withattribution/rose/fabrication/seeed fusion/Bom-template.csv

Part/Designator | Manufacture Part Number/Seeed SKU | Quantity
C1 | RHA0J471MCN1GS | 1
D1,D2 | CC0603KRX7R9BB102 | 2
