withattribution/rose/spice models/LT6240_positive_feedback.asc

B1: bv; V=(white(2e6*time)/10)
M1: nmos; BSB012NE2LX
M2: nmos; BSB012NE2LX
M3: nmos; BSB012NE2LX
M4: nmos; BSB012NE2LX
M5: pmos; FDS4465
M6: pmos; FDS4465
M9: nmos; BSB012NE2LX
M10: nmos; BSB012NE2LX
M11: pmos; FDS4465
M12: pmos; FDS4465
Q1: npn
Q2: npn
R1: res; 3.3k
R2: res; 10k
R3: res; 3.3k
R4: res; 10k
R5: res; 3.3k
R6: res; 10k
R7: res; 1K
R8: res; 1K
R9: res; 1K
R10: res; 1K
R11: res; 1K
U2: LTC6240
V1: voltage; PULSE(0 12 4m 10m 1m 5m 20m 3)
V3: voltage; PULSE(3.3 0 10m 0 0 10m)
V4: voltage; 3.3V
Named nets: 0, 12_REG_SIM, 3.3_REG, OP_OUT, NOISE, ENABLE_PULSE, DIGI_PIN, DIV, INPUT_TH, noise_sig, OP_INVERT, NAND_OUT, NOR_OUT, _OP_OUT, SHND
.tran 1u 80m
* .step param R LIST 53K 80K 100K
LT260 schmitt trigger design to mediate slow start up time of 12V 
switching regulator. Future design would invert the schmitt trigger 
and then feed that signal to a 2 channel NAND gate. The first channe 
will trigger when an associated digital signal is HIGH allowing the PWN 
circuit to be enabled.
To enable the LED dimming circuit the inverted schmitt trigger output 
would pass through the inverter then into the NAND gate, an 
associated digital pin will enable a high output which will pass through 
yet another inverter to activate the dimming circuit.
REV A designs shipped with a flaw that can be fixed by switching to a 
2 channel NOR gate. This design requires that the digital pin is LOW to 
activate both PWM and LED dimming circuits.
