withattribution/rose/spice models/LED_dimming.asc

M1: nmos; BSB012NE2LX
M2: nmos; BSB012NE2LX
R1: res; 6.81K
R2: res; 3.32K
R3: res; 3.3k
R4: res; 10k
R5: res; 3.3k
R6: res; 10k
R7: res; 3.3k
R8: res; 1K
U1: LT1783
U3: LT1783
V1: voltage; 3.3V
V2: voltage; 12V
V3: voltage; PULSE(0 3.3 0 1u 1u .5m 1m)
V4: voltage; PULSE(0 12 4m 10m 1m 5m 20m 3)
V5: voltage; PULSE(0 3.3 10m 0 0 10m 10 3)
Named nets: 3.3_REG, 0, 12_REG, ESP_PWM, DIM_PWM, REF, OP_OUT, ENABLE_PULSE, DIGI_PIN, DIV, INPUT_TH, IN
.tran 1u 80m
* .step param R LIST 53K 80K 100K
LT1783 0-3.3V PWM to 0-10V PWM for LED dimming
