withattribution/rose/spice models/Piezo_driver.asc

C1: cap; 1p; mfg="   ---" pn="   ---" type="   ---"
C3: cap; 56p; mfg="   ---" pn="   ---" type="   ---"
C4: cap; 1µ
C5: cap; .47µ
L2: ind; 47µ; Ipk=1.8 Rser=135m Rpar=32.406K Cpar=0 mfg="Bourns, Inc." pn="SRR1240-470M"
R5: res; 105K
R6: res; 10K
R8: res; 9.09K
R9: res; 10K
R10: res; 100K
R11: res; 453K
R12: res; 16.5K
U2: ICM7555
U3: LT3469
V1: voltage; 3.3V
V2: voltage; 12V
Named nets: 0, V12, V33, rc, PWM_OUT, driver_out, VCC_LT
.tran 1m 4m startup
.include ./icm7555.sub
100kHz pulse driving LT3469 piezo driver
