withattribution/rose/spice models/RC_7555.asc

C1: cap; 100p; mfg="   ---" pn="   ---" type="   ---"
C2: cap; 10n; mfg="   ---" pn="   ---" type="   ---"
R1: res; 100K
R2: res; 30K
U1: ICM7555
V1: voltage; 12V
V2: voltage; 3.3V
Named nets: 0, V12, V33, PWM_OUT, rc
.tran 1m 4m startup
.include ./icm7555.sub
