withattribution/rose/spice models/Solar_MPPT.asc

C3: cap; 10µ
C4: cap; 1µ
C5: cap; 10µ
C6: cap; 47µ
C7: cap; 47µ
D1: schottky; MBRS340
D5: zener; EDZV16B
D6: diode; 1N4148
L2: ind; 10µH; Rpar=10K
M1: pmos; FDS4685
R2: res; 221K
R3: res; 30K
R4: res; 330K
R5: res; 100K
R6: res; 9.09K
R7: res; 50k
R8: res; 10K
R9: res; .05
U1: LT3652
V2: voltage; 28
Named nets: 0, IN, V_BATT, REG_27
.tran 3m startup
14V to 32V MPPT
R1 = ((R2*Vin)/Vout) - R2
418K @ 14V
1MEG @32V
Basic MPPT model with similar components
(mostly for sizing inductor)
