withattribution/rose/hardware/rose.brd

## EAGLE design hardware/rose.brd (2016-06-25)

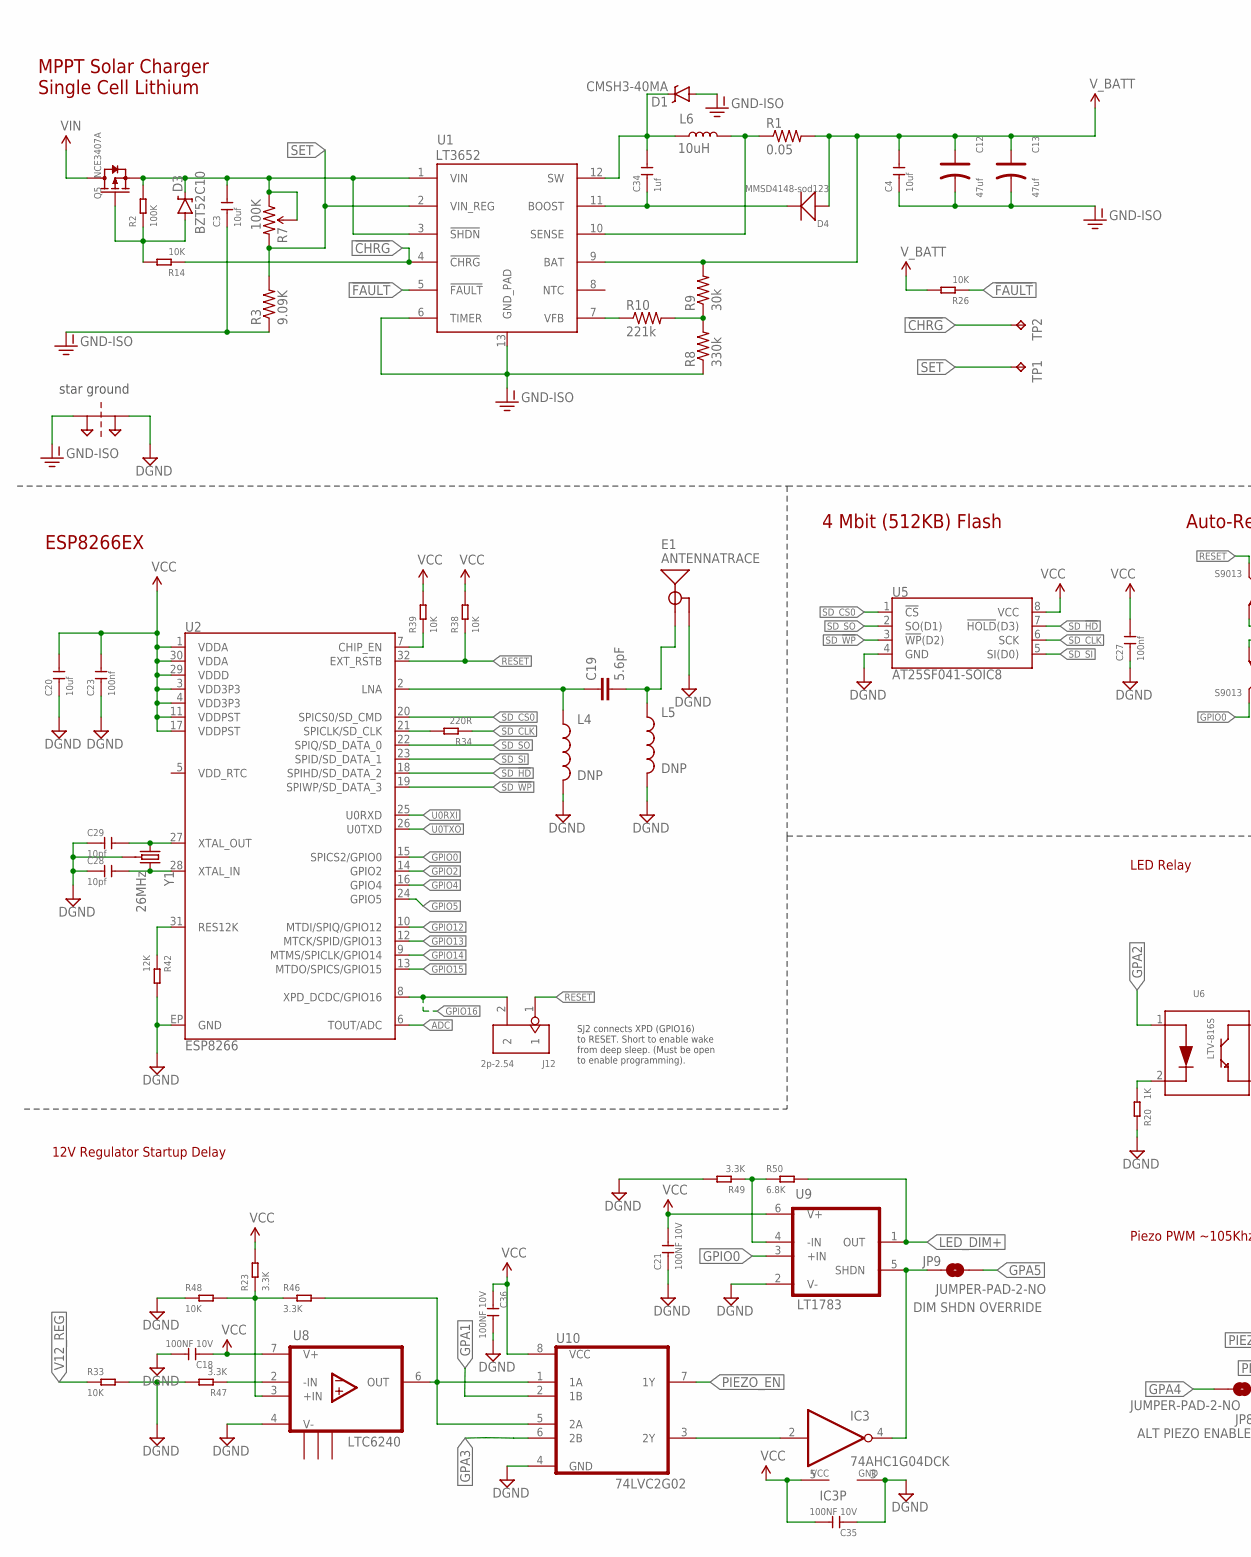
[picture p1: schematic rose.sch, sheet 1, part in row 1, column 1]

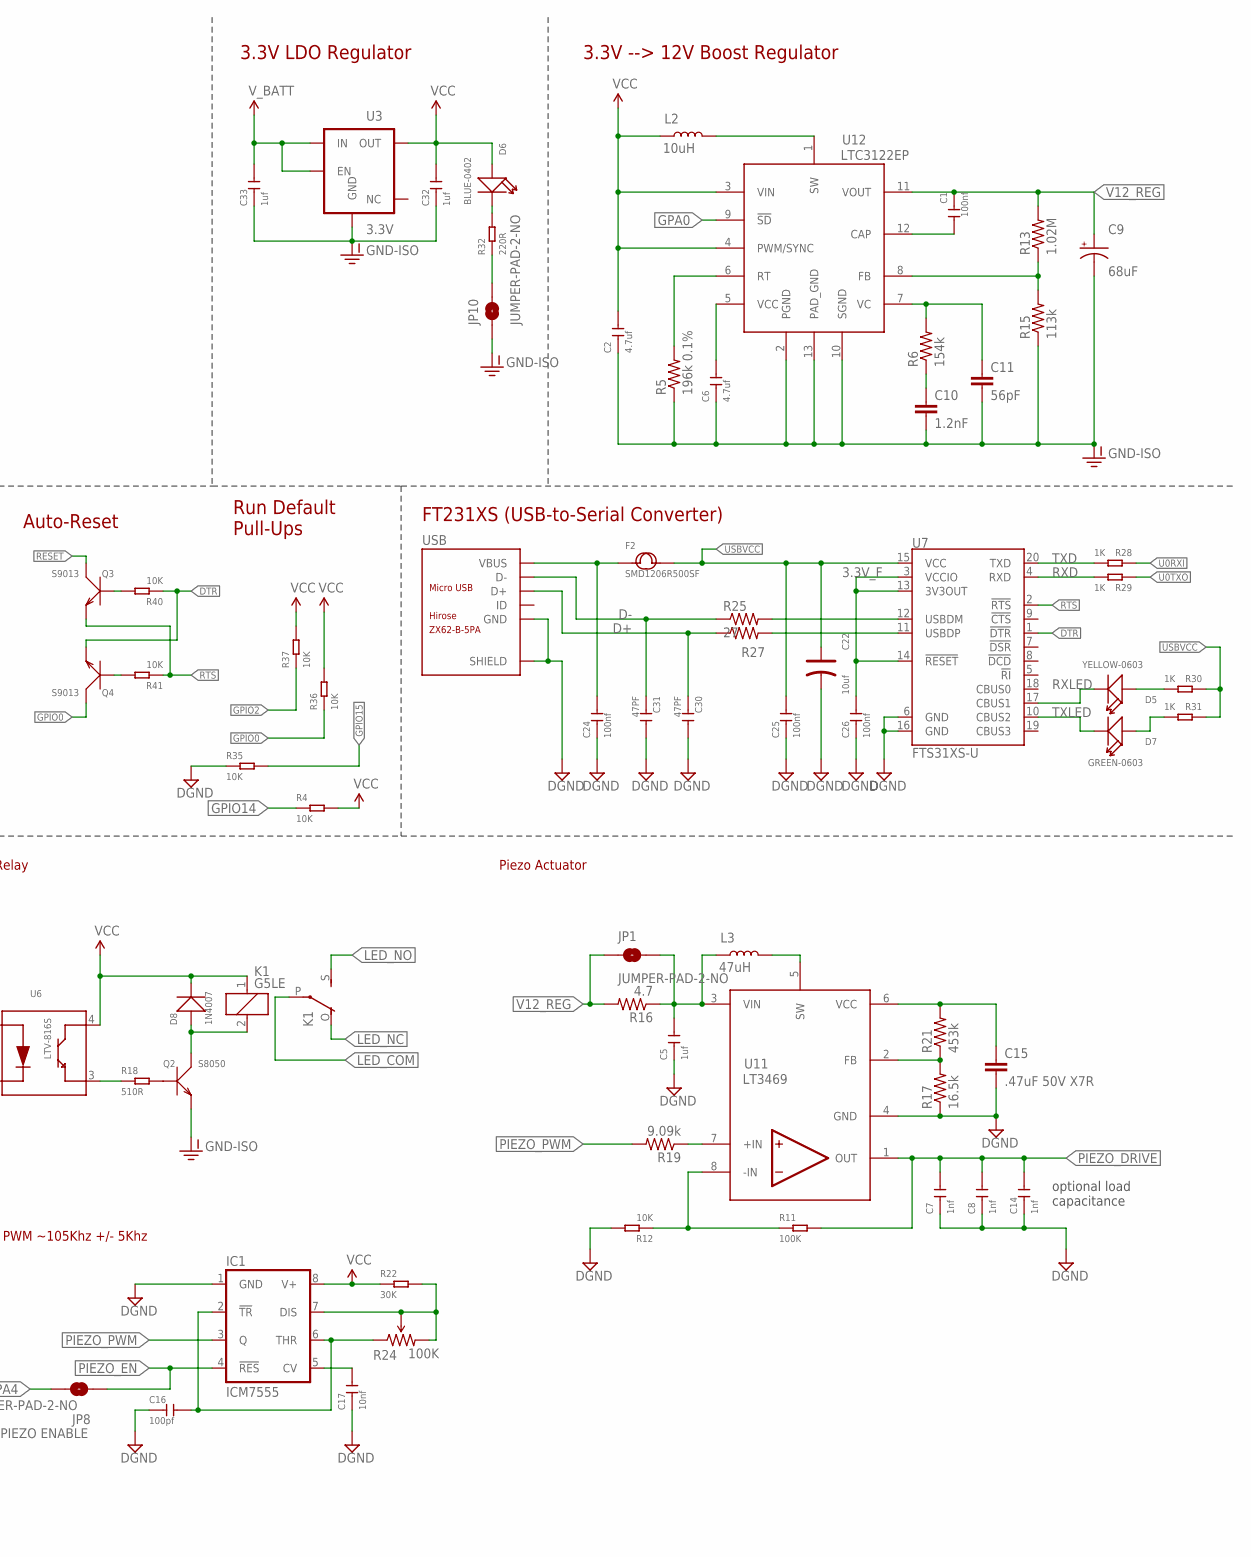
[picture p2: schematic rose.sch, sheet 1, part in row 1, column 2]

Parts:
C1, C23, C24, C25, C26, C27: 100nf; C0402
C2, C6: 4.7uf; C0603
C3, C4: 10uf; C0805
C5, C32, C33, C34: 1uf; C0603
C7, C8, C14: 1nf; C0402
C9: 68uF; EIA6032
C10: 1.2nF; 0603-CAP
C11: 56pF; 0603-CAP
C12, C13: 47uf; AVX-C
C15: .47uF 50V X7R; 0603-CAP
C16: 100pf; C0603
C17: 10nf; C0402
C18, C21, C35, C36: 100NF 10V; C0402
C19: 5.6pF; 0603-CAP
C20: 10uf; C0402
C22: 10uf; AVX-A
C28, C29: 10pf; C0402
C30, C31: 47PF; C0402
D1: CMSH3-40MA; SMA-DIODE
D3: BZT52C10; SOD-123
D4: MMSD4148-sod123; SOD-123
D5: YELLOW-0603; LED-0603
D6: BLUE-0402; LED-0402
D7: GREEN-0603; LED-0603
D8: 1N4007; DO-214AC
E1: ANTENNATRACE; TRACE_ANTENNA_2.4GHZ_25.7MM
F2: SMD1206R500SF; F1206
IC1: ICM7555; SO08
IC3: 74AHC1G04DCK; SC70-5
J12: 2p-2.54; H2-2.54
JP1, JP8, JP9, JP10: JUMPER-PAD-2-NO; PAD-JUMPER-2-NO_NO_SILK
K1: G5LE
L2, L6: 10uH; SRR1240
L3: 47uH; SRR1240
L4, L5: DNP; 0603
PT1: 2PT_GND_TIE
Q2: S8050; SOT-23
Q3, Q4: S9013; SOT-23
Q5: NCE3407A; SOT-23
R1: 0.05; 1206
R2, R11: 100K; R0603
R3: 9.09K; 0603-RES
R4, R12, R14, R26, R33, R35, R36, R37, R38, R39, R40, R41, R48: 10K; R0603
R5: 196k 0.1%; 0603-RES
R6: 154k; 0603-RES
R7, R24: 100K; ST4ETA
R8: 330k; 0603-RES
R9: 30k; 0603-RES
R10: 221k; 0603-RES
R13: 1.02M; 0603-RES
R15: 113k; 0603-RES
R16: 4.7; 0603-RES
R17: 16.5k; 0603-RES
R18: 510R; R0603
R19: 9.09k; 0603-RES
R20, R28, R29, R30, R31: 1K; R0603
R21: 453k; 0603-RES
R22: 30K; R0603
R23, R46, R47, R49: 3.3K; R0603
R25, R27: 27; 0603-RES
R32, R34: 220R; R0603
R42: 12K; R0603
R50: 6.8K; R0603
TP1, TP2: TPTP10SQ; TP10SQ
U1: LT3652; MSOP-12_GND
U2: ESP8266; QFN32
U3: 3.3V; SOT23-5
U5: AT25SF041-SOIC8; SO08
U6: LTV-816S; SMD4-2.54-4.6X6.5MM
U7: FTS31XS-U; SSOP20_L
U8: LTC6240; SOIC-8
U9: LT1783; TSOT-23-6
U10: 74LVC2G02; TSSOP-8
U11: LT3469; TSOT-23-8
U12: LTC3122EP; 12MSOP
USB: ZX62-B-5PA; MICRO-USB5+6P-SMD-0.65-AB
Y1: 26MHz; CRYSTAL-SMD-3.2X2.5

Connections:
3.3V_F: C26.2, U7.3 (VCCIO), U7.13 (3V3OUT), U7.14 (!RESET)
!CHRG: R14.1, TP2.TP, U1.4 (!CHRG)
!FAULT: R26.1, U1.5 (!FAULT)
ADC: U2.6 (TOUT/ADC); also elsewhere on the board
BOOST: C34.1, D4.-, U1.11 (BOOST)
CHIP_EN: R39.1, U2.7 (CHIP_EN)
D+: C30.1, R27.1, USB.3 (D+)
D-: C31.1, R25.1, USB.2 (D-)
DGND: C5.1, C7.1, C8.1, C14.1, C15.2, C16.1, C17.1, C18.2, C20.1, C21.1, C22.-, C23.1, C24.1, C25.1, C26.1, C27.1, C28.1, C29.1, C30.2, C31.2, C35.1, C36.2, E1.GND, E1.GND2 (GND), IC1.1 (GND), IC3.3 (GND), L4.2, L5.2, PT1.P$2, R12.2, R17.1, R20.2, R33.2, R35.1, R42.2, R47.2, R48.1, R49.2, U2.EP (GND), U5.4 (GND), U7.6 (GND), U7.16 (GND), U8.4 (V-), U9.2 (V-), U10.4 (GND), U11.4 (GND), USB.5 (GND), USB.P1 (SHIELD), USB.P2 (SHIELD), USB.P3 (SHIELD), USB.P4 (SHIELD), USB.P5 (SHIELD), USB.P6 (SHIELD), Y1.2 (GND), Y1.4 (GND); also elsewhere on the board
DTR: Q4.2 (E), R40.1, U7.1 (!DTR)
FB: R8.2, R9.1, R10.2
GND-ISO: C2.1, C3.1, C4.1, C6.1, C9.P$2 (-), C10.2, C11.2, C12.-, C13.-, C32.1, C33.1, D1.A, JP10.1, PT1.P$1, Q2.2 (E), R3.1, R5.1, R8.1, R15.1, U1.6 (TIMER), U1.13 (GND_PAD), U3.2 (GND), U12.2 (PGND), U12.10 (SGND), U12.13 (PAD_GND); also elsewhere on the board
GPA0: U12.9 (!SD); also elsewhere on the board
GPA1: U10.2 (1B); also elsewhere on the board
GPA2: U6.1 (ANODE); also elsewhere on the board
GPA3: U10.6 (2B); also elsewhere on the board
GPA4: JP8.1; also elsewhere on the board
GPA5: JP9.1; also elsewhere on the board
GPIO0: Q4.3 (C), R36.1, U2.15 (SPICS2/GPIO0), U9.3 (+IN)
GPIO2: R37.1, U2.14 (GPIO2); also elsewhere on the board
GPIO4: U2.16 (GPIO4); also elsewhere on the board
GPIO5: U2.24 (GPIO5); also elsewhere on the board
GPIO12: U2.10 (MTDI/SPIQ/GPIO12); also elsewhere on the board
GPIO13: U2.12 (MTCK/SPID/GPIO13); also elsewhere on the board
GPIO14: R4.1, U2.9 (MTMS/SPICLK/GPIO14); also elsewhere on the board
GPIO15: R35.2, U2.13 (MTDO/SPICS/GPIO15); also elsewhere on the board
GPIO16: J12.2, U2.8 (XPD_DCDC/GPIO16)
LED_COM: K1.P; also elsewhere on the board
LED_DIM+: R50.2, U9.1 (OUT); also elsewhere on the board
LED_NC: K1.O; also elsewhere on the board
LED_NO: K1.S; also elsewhere on the board
LNA: C19.1, L4.1, U2.2 (LNA)
LNA2: C19.2, E1.ANT (SIGNAL), L5.1
unnamed: R42.1, U2.31 (RES12K)
unnamed: C3.2, D3.C, Q5.2 (S), R2.2, R7.P$1 (CCW), R7.P$2 (WIPER), U1.1 (VIN), U1.3 (!SHDN)
unnamed: R10.1, U1.7 (VFB)
unnamed: R20.1, U6.2 (CATHODE)
unnamed: D3.A, Q5.1 (G), R2.1, R14.2
unnamed: IC1.7 (DIS), R22.2, R24.P$2 (WIPER), R24.P$3 (CW)
unnamed: C28.2, U2.28 (XTAL_IN), Y1.3 (2)
unnamed: D8.1 (+), K1.2, Q2.3 (C)
unnamed: C16.2, IC1.2 (!TR), IC1.6 (THR), R24.P$1 (CCW)
unnamed: R18.1, U6.3 (EMITER)
unnamed: C17.2, IC1.5 (CV)
unnamed: Q2.1 (B), R18.2
unnamed: C29.2, U2.27 (XTAL_OUT), Y1.1
unnamed: L2.P$2 (2), U12.1 (SW)
unnamed: R5.2, U12.6 (RT)
unnamed: C6.2, U12.5 (VCC)
unnamed: R46.2, U8.6 (OUT), U10.1 (1A), U10.5 (2A)
unnamed: C1.2, U12.12 (CAP)
unnamed: C11.1, R6.2, U12.7 (VC)
unnamed: R13.1, R15.2, U12.8 (FB)
unnamed: C10.1, R6.1
unnamed: L3.P$2 (2), U11.5 (SW)
unnamed: C5.2, JP1.2, L3.P$1 (1), R16.1, U11.3 (VIN)
unnamed: R11.1, R12.1, U11.8 (-IN)
unnamed: R19.1, U11.7 (+IN)
unnamed: C15.1, R21.2, U11.6 (VCC)
unnamed: R17.2, R21.1, U11.2 (FB)
unnamed: D7.+, R31.1
unnamed: D5.+, R30.1
unnamed: R25.2, U7.12 (USBDM)
unnamed: R27.2, U7.11 (USBDP)
unnamed: D6.-, R32.2
unnamed: JP10.2, R32.1
unnamed: Q3.1 (B), R40.2
unnamed: Q4.1 (B), R41.2
unnamed: R23.1, R46.1, R48.2, U8.3 (+IN)
unnamed: R47.1, U8.2 (-IN)
unnamed: R49.1, R50.1, U9.4 (-IN)
unnamed: IC3.2 (I), U10.3 (2Y)
unnamed: IC3.4 (O), JP9.2, U9.5 (SHDN)
PIEZO_DRIVE: C7.2, C8.2, C14.2, R11.2, U11.1 (OUT); also elsewhere on the board
PIEZO_EN: IC1.4 (!RES), JP8.2, U10.7 (1Y)
PIEZO_PWM: IC1.3 (Q), R19.2
RESET: J12.1, Q3.3 (C), R38.1, U2.32 (EXT_RSTB)
RTS: Q3.2 (E), R41.1, U7.2 (!RTS)
RXD: R29.1, U7.4 (RXD)
RXLED: D5.-, U7.17 (CBUS1)
SD_!HD!: U2.18 (SPIHD/SD_DATA_2), U5.7 (!HOLD!(D3))
SD_!WP!: U2.19 (SPIWP/SD_DATA_3), U5.3 (!WP!(D2))
SD_CLK: R34.1, U5.6 (SCK)
SD_CLK0: R34.2, U2.21 (SPICLK/SD_CLK)
SD_CS0: U2.20 (SPICS0/SD_CMD), U5.1 (!CS!)
SD_SI: U2.23 (SPID/SD_DATA_1), U5.5 (SI(D0))
SD_SO: U2.22 (SPIQ/SD_DATA_0), U5.2 (SO(D1))
SENSE: L6.P$2 (2), R1.1, U1.10 (SENSE)
SET: R3.2, R7.P$3 (CW), TP1.TP, U1.2 (VIN_REG)
SW: C34.2, D1.C, L6.P$1 (1), U1.12 (SW)
TXD: R28.1, U7.20 (TXD)
TXLED: D7.-, U7.10 (CBUS2)
U0RXI: R28.2, U2.25 (U0RXD); also elsewhere on the board
U0TXO: R29.2, U2.26 (U0TXD); also elsewhere on the board
USBVCC: C22.+, C25.2, F2.2, R30.2, R31.2, U7.15 (VCC)
V12_REG: C1.1, C9.P$1 (+), JP1.1, R13.2, R16.2, R33.1, U12.11 (VOUT); also elsewhere on the board
VBUS: C24.2, F2.1, USB.1 (VBUS)
VCC: C2.2, C18.1, C20.2, C21.2, C23.2, C27.2, C32.2, C35.2, C36.1, D6.+, D8.2 (-), IC1.8 (V+), IC3.5 (VCC), K1.1, L2.P$1 (1), R4.2, R22.1, R23.2, R36.2, R37.2, R38.2, R39.2, U2.1 (VDDA), U2.3 (VDD3P3), U2.4 (VDD3P3), U2.11 (VDDPST), U2.17 (VDDPST), U2.29 (VDDD), U2.30 (VDDA), U3.5 (OUT), U5.8 (VCC), U6.4 (COLLECTOR), U8.7 (V+), U9.6 (V+), U10.8 (VCC), U12.3 (VIN), U12.4 (PWM/SYNC); also elsewhere on the board
VIN: Q5.3 (D); also elsewhere on the board
V_BATT: C4.2, C12.+, C13.+, C33.2, D4.+, R1.2, R9.2, R26.2, U1.9 (BAT), U3.1 (IN), U3.3 (EN); also elsewhere on the board

Notes on the sheet:
optional load capacitance
FT231XS (USB-to-Serial Converter)
Auto-Reset
Run Default Pull-Ups
SJ2 connects XPD (GPIO16) to RESET. Short to enable wake from deep sleep. (Must be open to enable programming).
MPPT Solar Charger Single Cell Lithium
3.3V LDO Regulator
3.3V --> 12V Boost Regulator
ESP8266EX
4 Mbit (512KB) Flash
Piezo PWM ~105Khz +/- 5Khz
LED Relay
12V Regulator Startup Delay
Piezo Actuator
star ground
DIM SHDN OVERRIDE
ALT PIEZO ENABLE

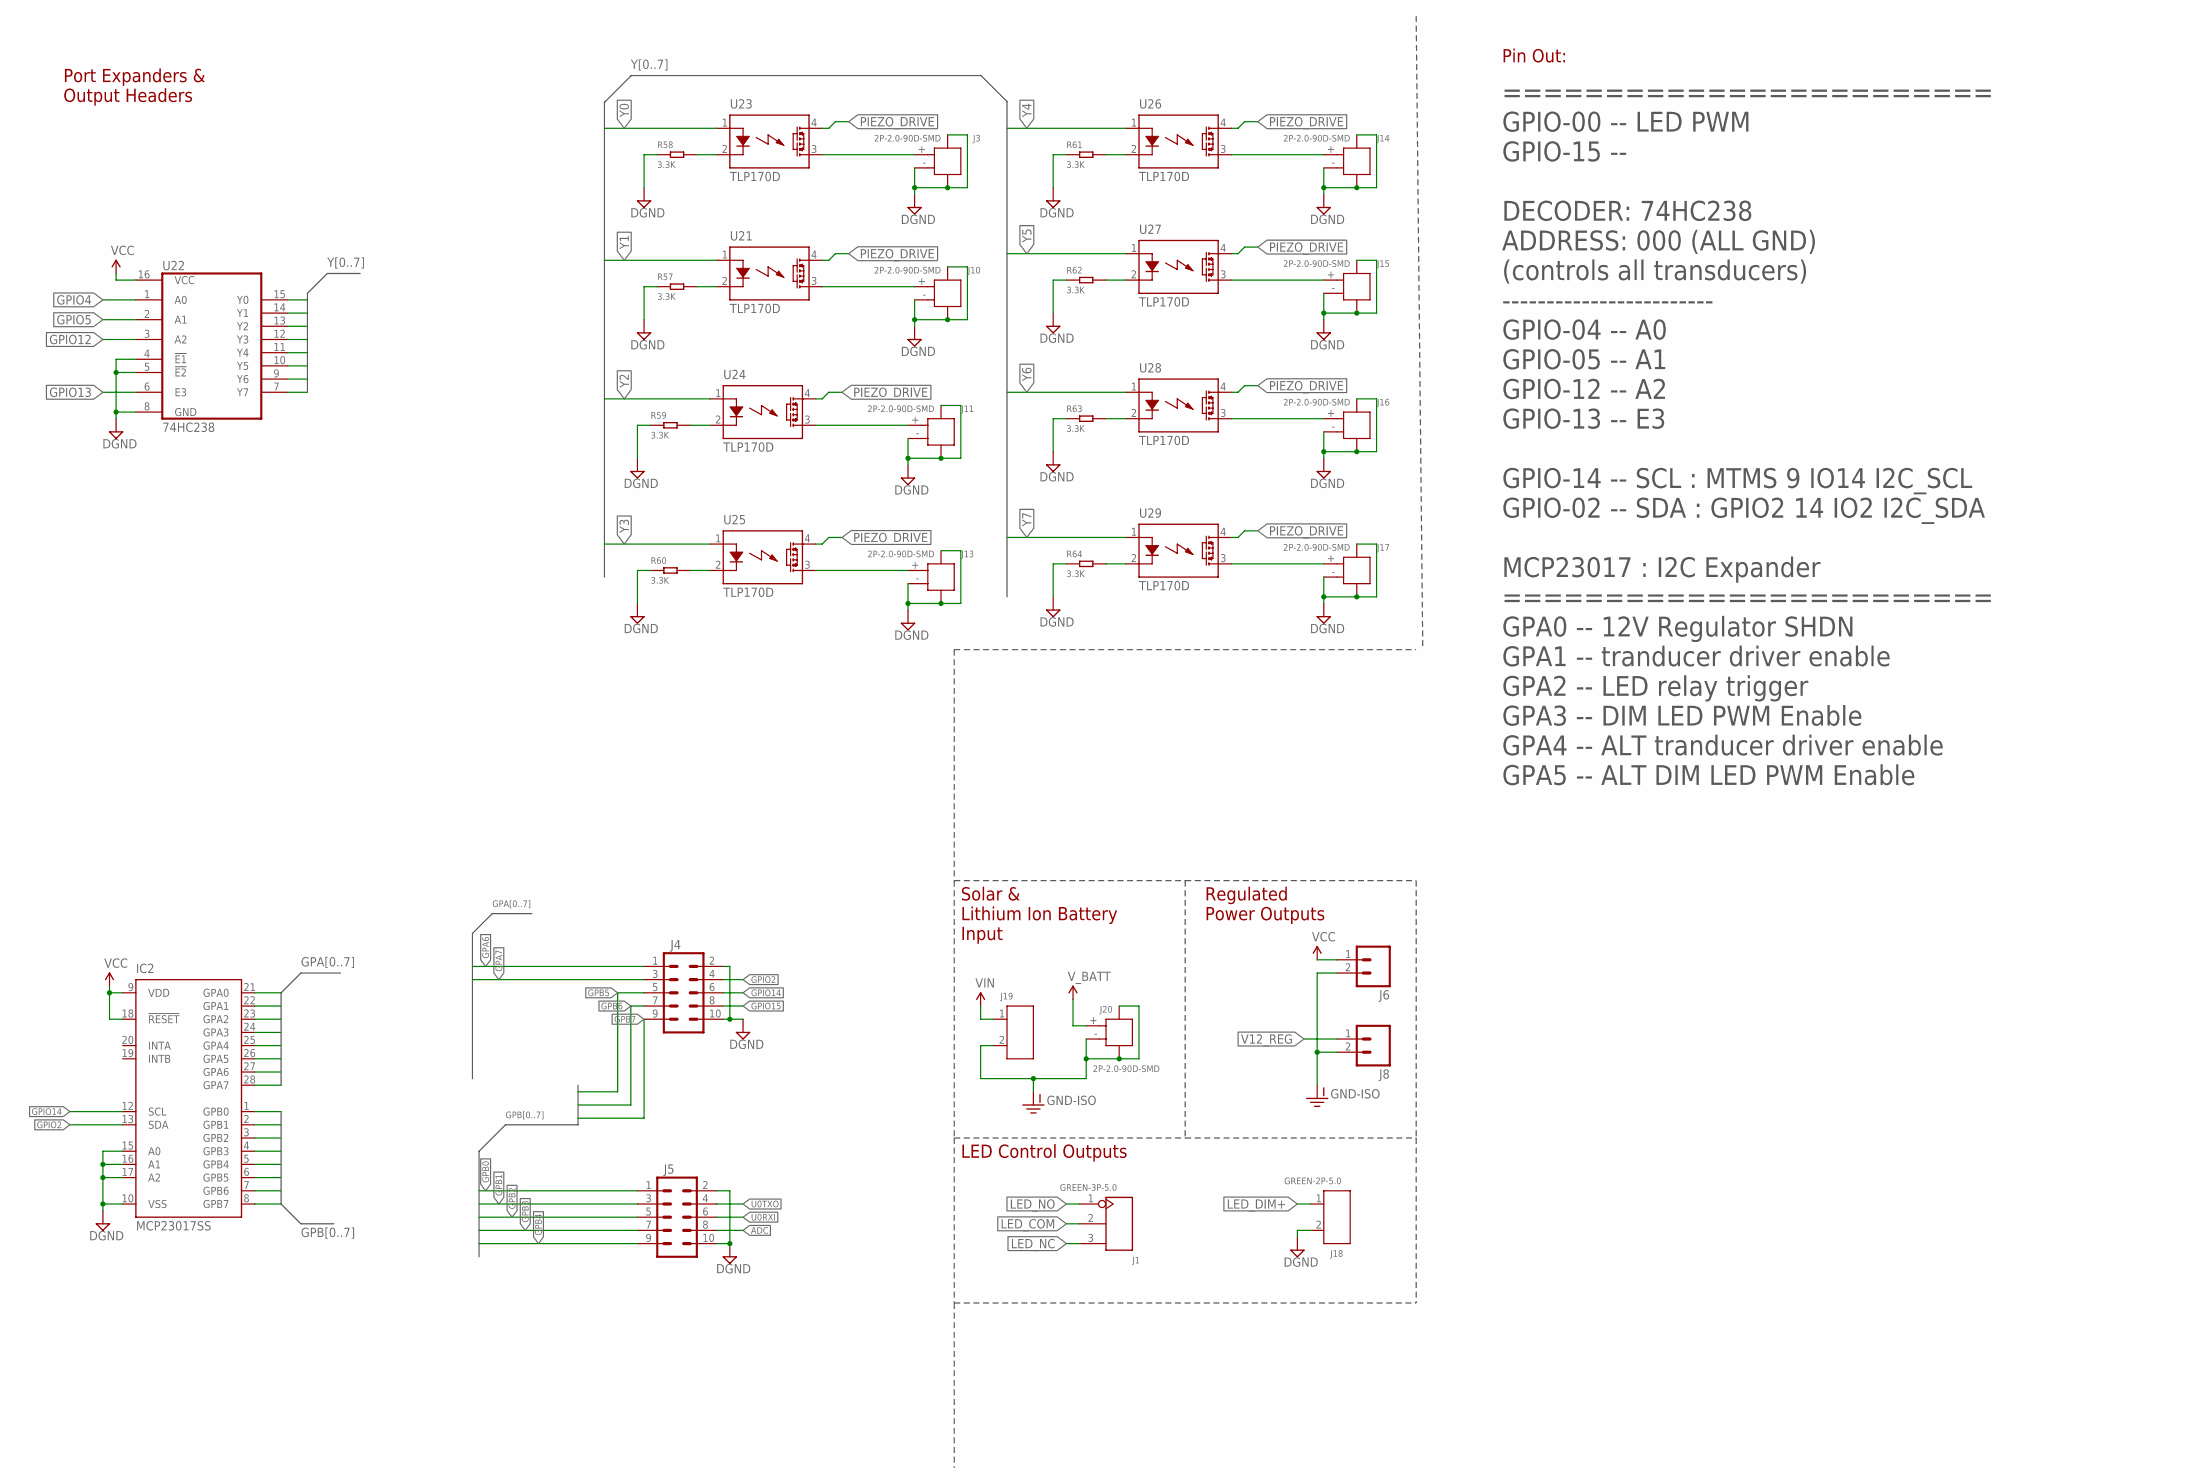
[picture p3: schematic rose.sch, sheet 2]

Parts:
IC2: MCP23017SS; SSOP28
J1: GREEN-3P-5.0; H3-5.0-15.5X8.0MM
J3, J10, J11, J13, J14, J15, J16, J17, J20: 2P-2.0-90D-SMD; HW2-SMD-2.0-90D
J4, J5: M05X2NO_SILK; 2X5_NOSILK
J6, J8: M02PTH; 1X02
J18, J19: GREEN-2P-5.0; H2-5.0-10.5X8.0MM
R57, R58, R59, R60, R61, R62, R63, R64: 3.3K; R0603
U21, U23, U24, U25, U26, U27, U28, U29: TLP170D; 4-SOP
U22: 74HC238; TSSOP-16

Connections:
ADC: J5.8; also elsewhere on the board
DGND: IC2.10 (VSS), IC2.15 (A0), IC2.16 (A1), IC2.17 (A2), J3.3, J3.4, J3.- (2), J4.2, J4.10, J5.2, J5.10, J10.3, J10.4, J10.- (2), J11.3, J11.4, J11.- (2), J13.3, J13.4, J13.- (2), J14.3, J14.4, J14.- (2), J15.3, J15.4, J15.- (2), J16.3, J16.4, J16.- (2), J17.3, J17.4, J17.- (2), J18.2, R57.1, R58.1, R59.1, R60.1, R61.1, R62.1, R63.1, R64.1, U22.4 (!E1), U22.5 (!E2), U22.8 (GND); also elsewhere on the board
GND-ISO: J6.2, J8.2, J19.2, J20.3, J20.4, J20.- (2); also elsewhere on the board
GPA0: IC2.21 (GPA0); also elsewhere on the board
GPA1: IC2.22 (GPA1); also elsewhere on the board
GPA2: IC2.23 (GPA2); also elsewhere on the board
GPA3: IC2.24 (GPA3); also elsewhere on the board
GPA4: IC2.25 (GPA4); also elsewhere on the board
GPA5: IC2.26 (GPA5); also elsewhere on the board
GPA6: IC2.27 (GPA6), J4.1
GPA7: IC2.28 (GPA7), J4.3
GPB0: IC2.1 (GPB0), J5.1
GPB1: IC2.2 (GPB1), J5.3
GPB2: IC2.3 (GPB2), J5.5
GPB3: IC2.4 (GPB3), J5.7
GPB4: IC2.5 (GPB4), J5.9
GPB5: IC2.6 (GPB5), J4.5
GPB6: IC2.7 (GPB6), J4.7
GPB7: IC2.8 (GPB7), J4.9
GPIO2: IC2.13 (SDA), J4.4; also elsewhere on the board
GPIO4: U22.1 (A0); also elsewhere on the board
GPIO5: U22.2 (A1); also elsewhere on the board
GPIO12: U22.3 (A2); also elsewhere on the board
GPIO13: U22.6 (E3); also elsewhere on the board
GPIO14: IC2.12 (SCL), J4.6; also elsewhere on the board
GPIO15: J4.8; also elsewhere on the board
LED_COM: J1.2; also elsewhere on the board
LED_DIM+: J18.1; also elsewhere on the board
LED_NC: J1.3; also elsewhere on the board
LED_NO: J1.1; also elsewhere on the board
unnamed: J10.+ (1), U21.3 (DS2)
unnamed: R57.2, U21.2 (K)
unnamed: J11.+ (1), U24.3 (DS2)
unnamed: R59.2, U24.2 (K)
unnamed: J3.+ (1), U23.3 (DS2)
unnamed: R58.2, U23.2 (K)
unnamed: J13.+ (1), U25.3 (DS2)
unnamed: R60.2, U25.2 (K)
unnamed: J14.+ (1), U26.3 (DS2)
unnamed: R61.2, U26.2 (K)
unnamed: J15.+ (1), U27.3 (DS2)
unnamed: R62.2, U27.2 (K)
unnamed: J16.+ (1), U28.3 (DS2)
unnamed: R63.2, U28.2 (K)
unnamed: J17.+ (1), U29.3 (DS2)
unnamed: R64.2, U29.2 (K)
PIEZO_DRIVE: U21.4 (DS1), U23.4 (DS1), U24.4 (DS1), U25.4 (DS1), U26.4 (DS1), U27.4 (DS1), U28.4 (DS1), U29.4 (DS1); also elsewhere on the board
U0RXI: J5.6; also elsewhere on the board
U0TXO: J5.4; also elsewhere on the board
V12_REG: J8.1; also elsewhere on the board
VCC: IC2.9 (VDD), IC2.18 (!RESET), J6.1, U22.16 (VCC); also elsewhere on the board
VIN: J19.1; also elsewhere on the board
V_BATT: J20.+ (1); also elsewhere on the board
Y0: U22.15 (Y0), U23.1 (A)
Y1: U21.1 (A), U22.14 (Y1)
Y2: U22.13 (Y2), U24.1 (A)
Y3: U22.12 (Y3), U25.1 (A)
Y4: U22.11 (Y4), U26.1 (A)
Y5: U22.10 (Y5), U27.1 (A)
Y6: U22.9 (Y6), U28.1 (A)
Y7: U22.7 (Y7), U29.1 (A)

Notes on the sheet:
======================== GPIO-00 -- LED PWM GPIO-15 -- DECODER: 74HC238 ADDRESS: 000 (ALL GND) (controls all transducers) ------------------------ GPIO-04 -- A0 GPIO-05 -- A1 GPIO-12 -- A2 GPIO-13 -- E3 GPIO-14 -- SCL : MTMS 9 IO14 I2C_SCL GPIO-02 -- SDA : GPIO2 14 IO2 I2C_SDA MCP23017 : I2C Expand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
Solar & Lithium Ion Battery Input
LED Control Outputs
Port Expanders & Output Headers
Regulated Power Outputs
Pin Out:

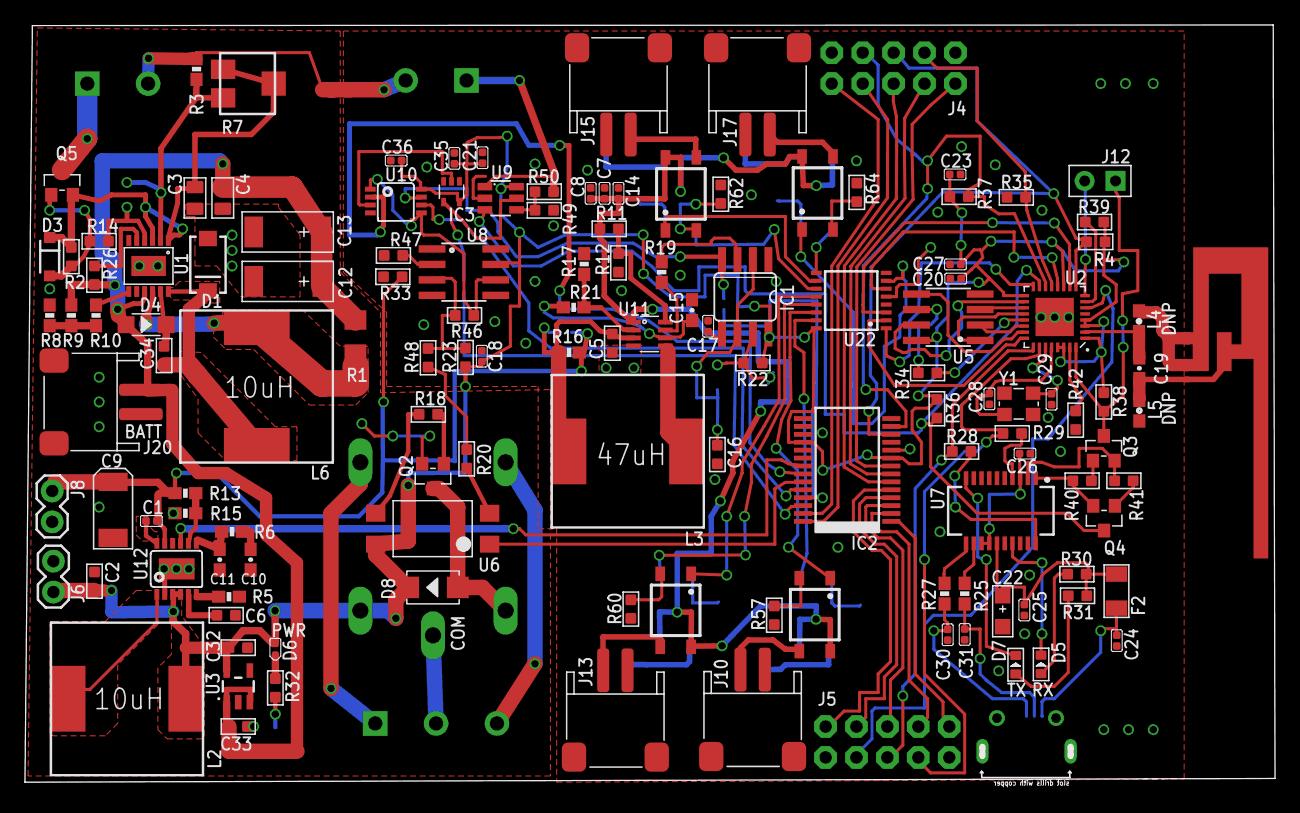
[picture p4: board rose.brd from above]

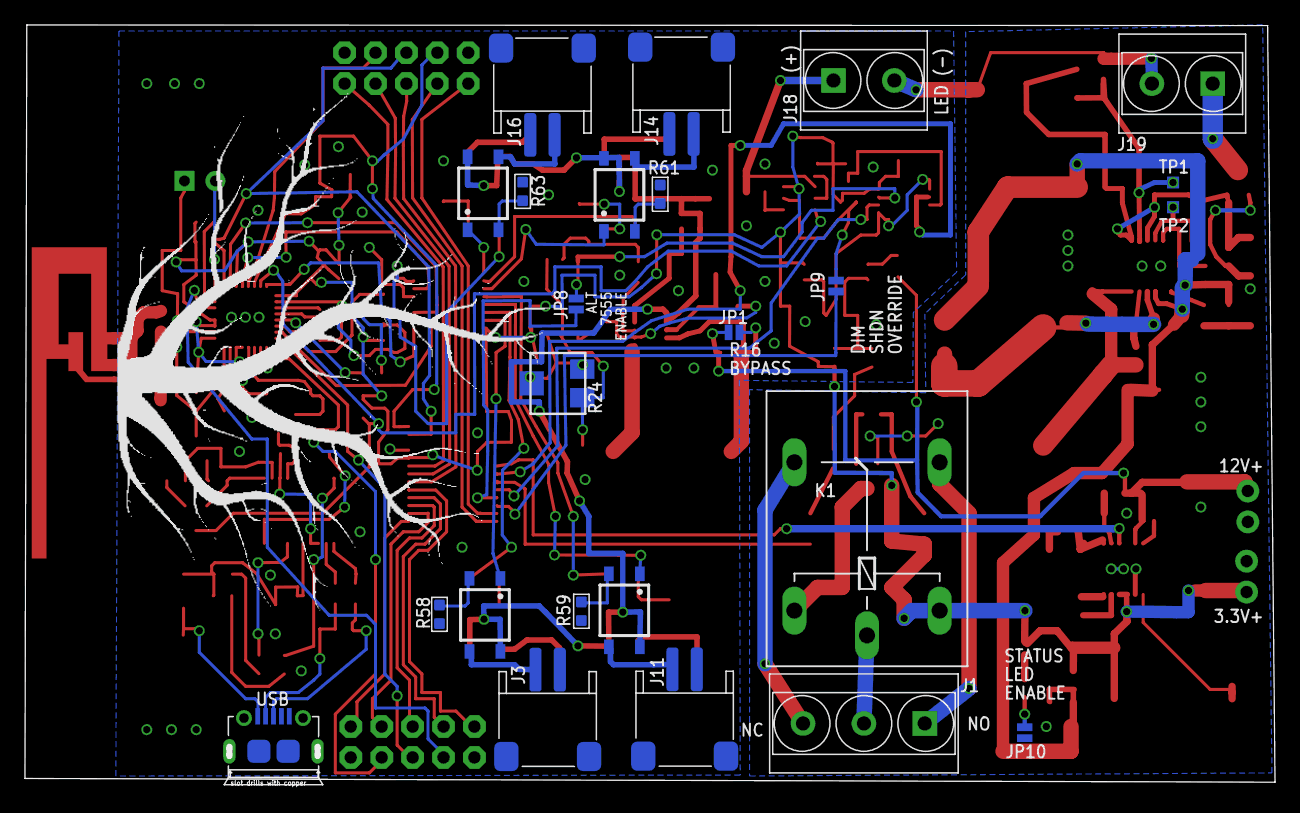
[picture p5: board rose.brd from below]

Board: 2 copper layers, 102.7 x 62.2 mm, 160 parts (24 on the bottom side), 134 nets.

Other parts of the board:
U$1: LEAF
