withattribution/rose/(commit log)

2016-06-25 rev A out for production: initial commit
    [BOM.csv, Bom-template.csv, rose.brd, rose.sch]
2016-06-25 adding external part digikey links
    [MPNExternalLinks.csv]
2025-10-31 adding a basic piezo driver osx ltspice simulation
2025-10-31 Add SPICE model for piezo driver circuit
    This file defines a SPICE model for a piezo driver circuit, including user parameters, drive settings, and measurements for analysis.
2025-10-31 remove binary driver.cir
2025-11-10 adding fulling verified working piezo driver simulation
2025-11-10 modified driver simulation with in-stock RDRV resistor pair and other working parts with links
2025-11-11 adding driver BOM without hbridge components
2025-11-11 modified BOM markdown with properly calculated R_SENSE expected measured voltages
2025-11-11 updated bom v1.0
2025-11-17 hbridge and driver power boms
